danielwilczak101/Evolving-altitude-robot/graphs/Jeff/generation_data.png

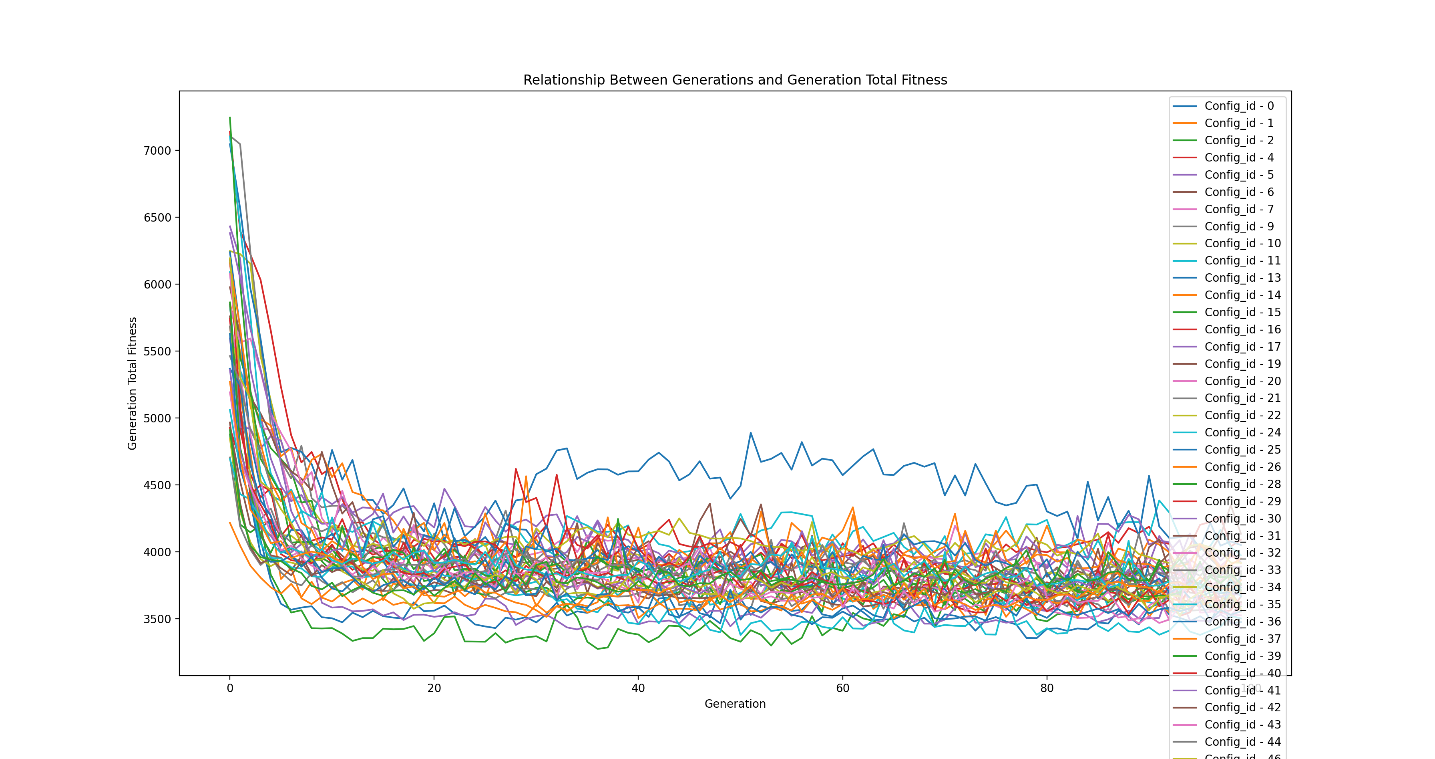
graphs/Jeff/generation_data.png
