danielwilczak101/Evolving-altitude-robot/graphs/Jeff/lowest_chromosome.png

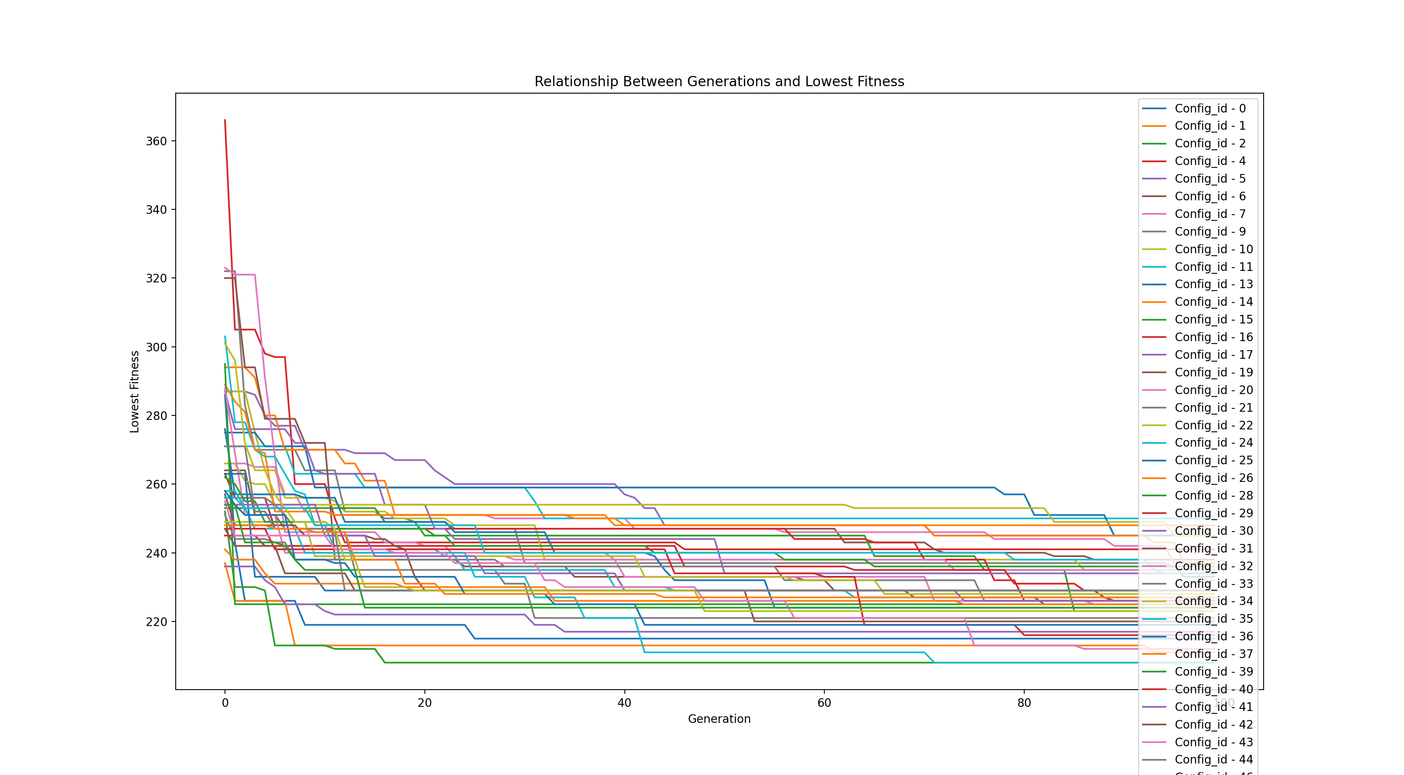
graphs/Jeff/lowest_chromosome.png
