danielwilczak101/Evolving-altitude-robot/graphs/Kyle/Lowest_chromosome.png

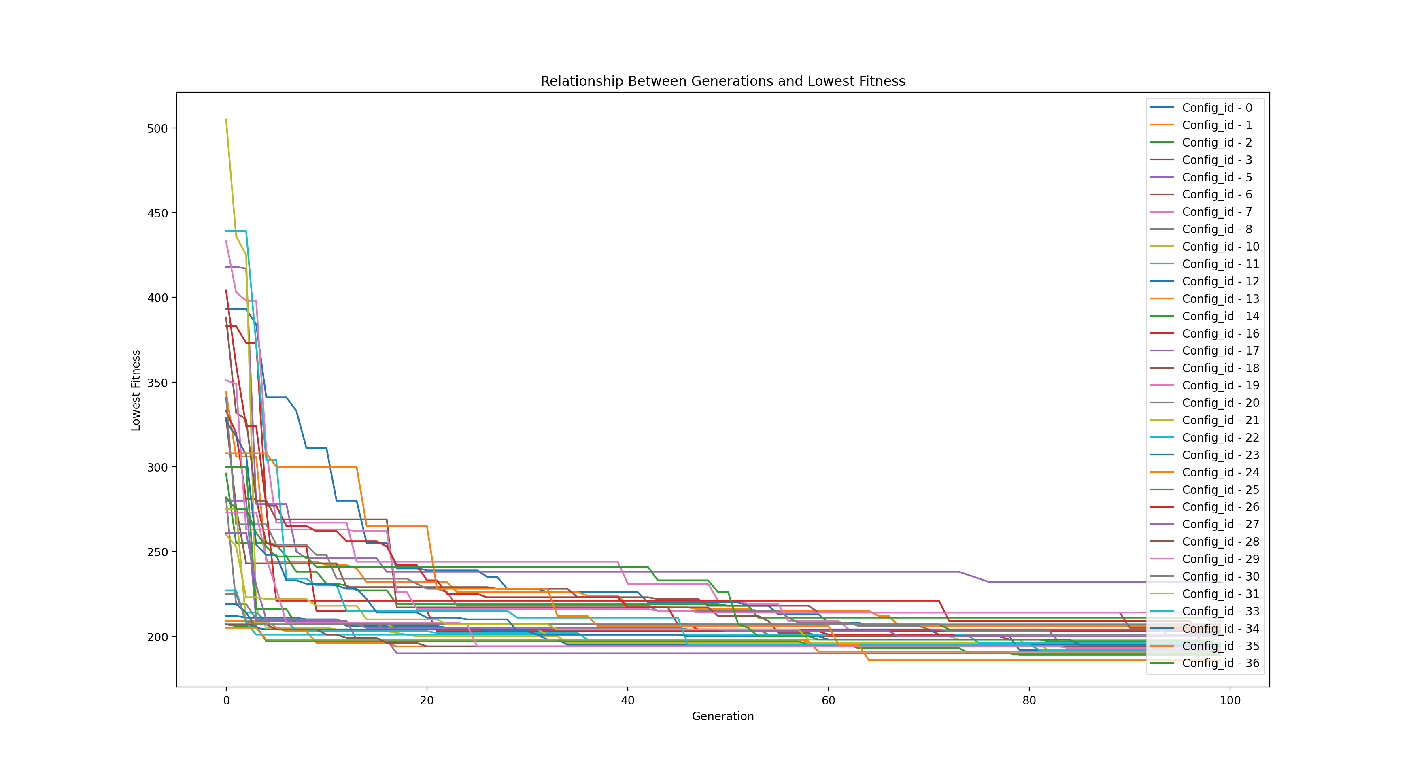
graphs/Kyle/Lowest_chromosome.png
