danielwilczak101/Evolving-altitude-robot/graphs/Linda/Generation_data.png

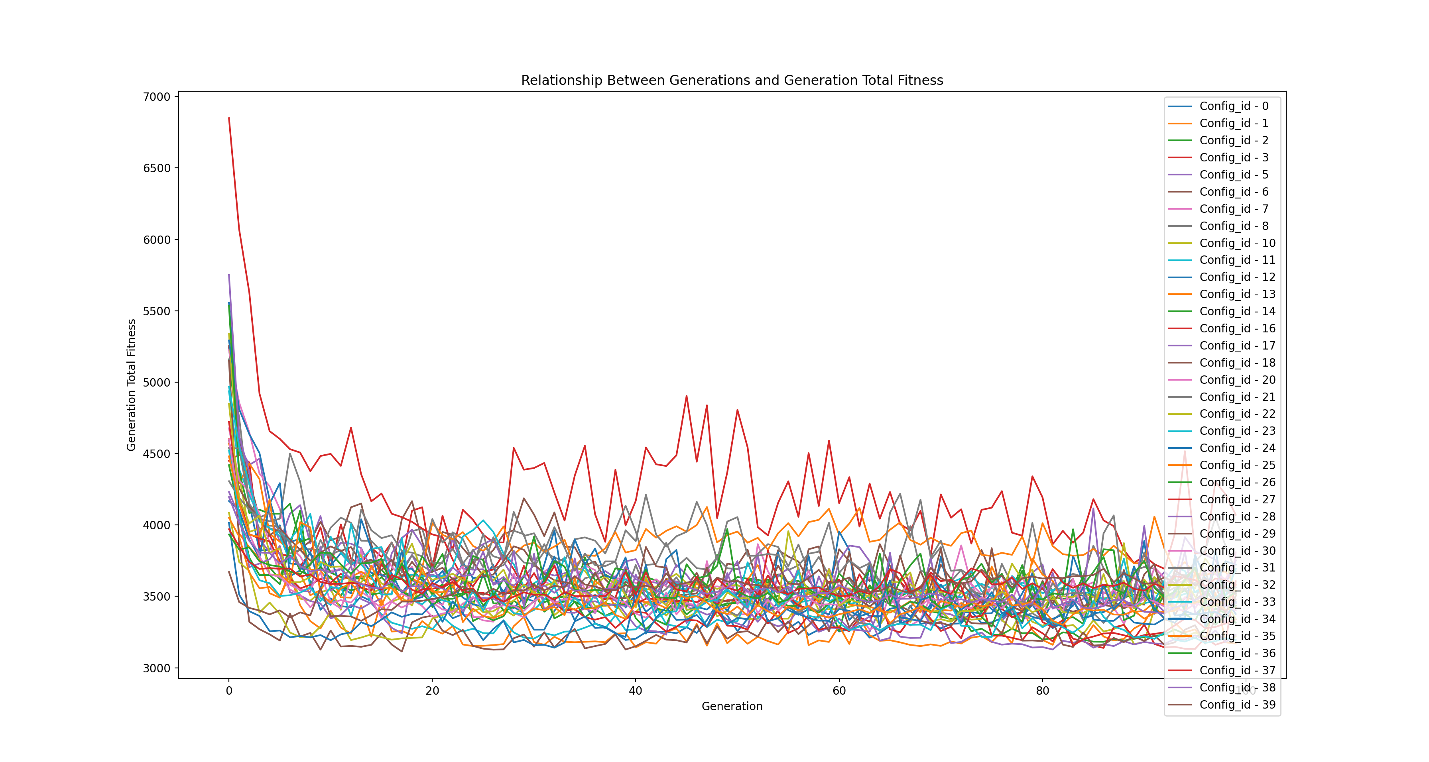
graphs/Linda/Generation_data.png
