danielwilczak101/Evolving-altitude-robot/graphs/Linda/Lowest_chromsome.png

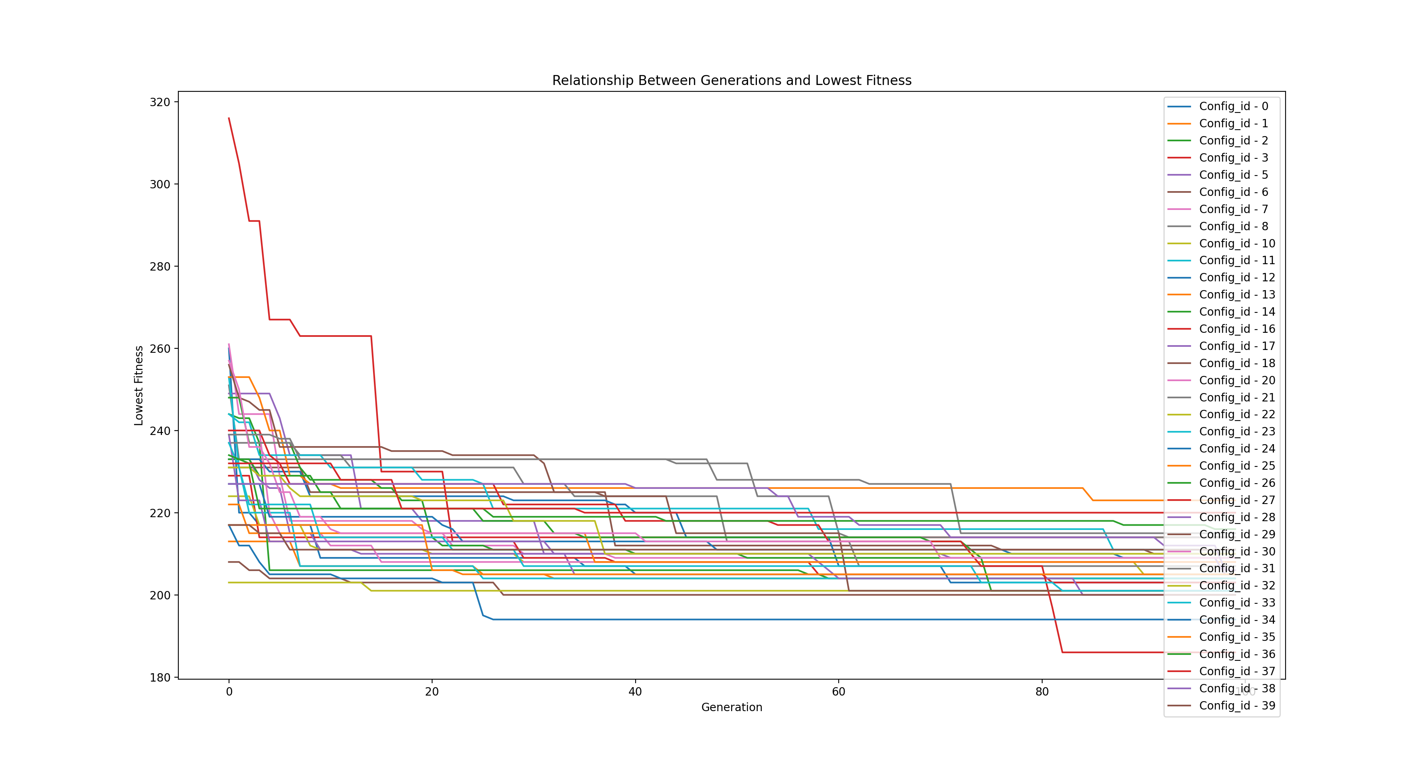
graphs/Linda/Lowest_chromsome.png
