danielwilczak101/Evolving-altitude-robot/3d_print_assembly/Readme.md

## 3D Printing and assembly can be found here.

### STL Files for printing:
All the required 3D printed parts are located in one zipped file on the Thingverse linked below, download, unzip and import into your slicer software to 3D print
<table>
<thead>
<tr>
<th><strong>3D Printed Part</strong></th>
<th align="right"><strong>Quantity</strong></th>
<th><strong>URL</strong></th>
<th><strong>Material</strong></th>
<th><strong>Supports</strong></th>
<th><strong>Print Time</strong></th>
</tr>
</thead>
<tbody>
<tr>
<td>GA Front Test Stand</td>
<td align="right">1</td>
<td><a href="https://www.thingiverse.com/thing:4819932">Thingiverse</a></td>
<td>PLA</td>
<td>Yes: Touching Build Plate Only</td>
<td>10-12 hours</td>
</tr>
<tr>
<td>GA Front Back Stand</td>
<td align="right">1</td>
<td><a href="https://www.thingiverse.com/thing:4819932">Thingiverse</a></td>
<td>PLA</td>
<td>None</td>
<td>10-12 hours</td>
</tr>
<tr>
<td>EDF Holder</td>
<td align="right">1</td>
<td><a href="https://www.thingiverse.com/thing:4819932">Thingiverse</a></td>
<td>PLA</td>
<td>None</td>
<td>6-8 hours</td>
</tr>
<tr>
<td>Hole Guide</td>
<td align="right">1</td>
<td><a href="https://www.thingiverse.com/thing:4819932">Thingiverse</a></td>
<td>PLA</td>
<td>None</td>
<td>4-6 hours</td>
</tr>
</table>

## Assembly

This page details the hardware setup instructions for creating the Evolving Altitude Robot

### Wiring Diagram


### Carbon Fiber Tube and EDF Assembly 
__(add images of 3d prints, carbon fiber tube and how to insert EDF )__

<a href="https://github.com/EREPPLab/Test_WIKI/blob/media/Images/Tube_Alignment_Tool_Uninstalled.JPG">
</a>

<a href="https://github.com/EREPPLab/Test_WIKI/blob/media/Images/Tube_Hole_Alignment_Installed.JPG">
</a>

1. Use the 3D printed Tube Hole Guide to drill a hole in the carbon fiber tube using a 5/32 drill bit
    - Push carbon fiber tube all the way into 3D printed Tube Hole Guide until you hit the wall and then drill hole  

2. Using pliers open up the 3D printed EDF Holder and slide in the EDF to lock in place feeding the wires below
    - Feed wires into the bottom hole on the 3D printed EDF Holder 

3. Feed the 3 wires that you created earlier through the carbon fiber tube
    - Male 3.5 mm bullet connectors opposite of the end of the hole
    - Female 3.5 mm bullet connectors on the same side as the hole you drilled

4. Connect the 3 EDF wires with the 3 connectors of the extension wire

5. Slide the carbon fiber tube into the 3D printed EDF Holder tucking the wires nicely into the cut out

## Hardware Assembly

### Step 1:  Snap in place the Arduino into 3D printed Back Mount
<a href="https://raw.githubusercontent.com/EREPPLab/Test_WIKI/media/Images/Back_Mount_Arduino_Uninstalled.JPG">
</a>

<a href="https://raw.githubusercontent.com/EREPPLab/Test_WIKI/media/Images/Back_Mount_Arduino_part1_insert.JPG">
</a>

<a href="https://raw.githubusercontent.com/EREPPLab/Test_WIKI/media/Images/Back_Mount_Arduino_Installed.JPG">
</a>

<a href="https://raw.githubusercontent.com/EREPPLab/Test_WIKI/media/Images/Back_Mount_Arduino_Installed2.JPG">
</a>

### Step 2:  Snap in place the Ultrasonic sensor into 3D printed Front Mount

<a href="https://raw.githubusercontent.com/EREPPLab/Test_WIKI/media/Images/Front_Mount_Ultrasonic_Outside.JPG">
</a>

<a href="https://raw.githubusercontent.com/EREPPLab/Test_WIKI/media/Images/Front_Mount_Ultrasonic_Inserted.JPG">
</a>

### Step 3:  Slide the Front 3D printed Mount into the Back 3D printed Mount

<a href="https://raw.githubusercontent.com/EREPPLab/Test_WIKI/media/Images/Frount_Back_Mounts_Unassembled.JPG">
</a>

<a href="https://raw.githubusercontent.com/EREPPLab/Test_WIKI/media/Images/Front_Back_Mount_Wire_Connected.JPG">
</a>

### Step 4:  Connect the 4 pin JSD connector wire from the ultrasonic sensor to Arduino shield 4 pin Female JSD connector

### Step 5:  Insert the ESC into the 3D printed Back Mount 
    - 3.5 mm Bullet Connectors and XT60 connector stays sticking out the back
    - Only 3 pin JSD connector feeds through hole to connect to Arduino Shield
<a href="https://raw.githubusercontent.com/EREPPLab/Test_WIKI/media/Images/Back_Mount_ESC_Uninstalled.JPG">
</a>

<a href="https://raw.githubusercontent.com/EREPPLab/Test_WIKI/media/Images/Back_Mount_ESC_Installed.JPG">
</a>

<a href="https://raw.githubusercontent.com/EREPPLab/Test_WIKI/media/Images/Back_Mount_ESC_Installed2.JPG">
</a>

### Step 6: Connect the ESC 3 pin male JSD connector to the Arduino Shield 3 pin female connector  

<a href="https://raw.githubusercontent.com/EREPPLab/Test_WIKI/media/Images/Back_Mount_ESC&Arduino_Installed.JPG">
</a>

<a href="https://raw.githubusercontent.com/EREPPLab/Test_WIKI/media/Images/Back_Mount_ESC_plugedin_Arduino.JPG">
</a>

### Step 7: Line up the Carbon Fiber Drilled Hole with the hole on the Back Mount and insert screw to secure tube in place
    - Make sure to not to tighten bolt too tight allow the carbon fiber tube to easily pivot up and down

### Step 8: Connect the EDF extension wire 3.5 mm male bullet connectors to the ESC 3.5 mm female bullet connectors 
    - If the EDF is spinning the wrong direction swap one of these wires with another

<a href="https://raw.githubusercontent.com/EREPPLab/Test_WIKI/media/Images/Mount_&_Tube_ESC_wires_unconnected.JPG">
</a>

<a href="https://raw.githubusercontent.com/EREPPLab/Test_WIKI/media/Images/Mount_&_ESC_Wires_UnConnected_Zoom.JPG">
</a>

<a href="https://raw.githubusercontent.com/EREPPLab/Test_WIKI/media/Images/Mount_&_ESC_Wires_Connected.JPG">
</a>

<a href="https://raw.githubusercontent.com/EREPPLab/Test_WIKI/media/Images/Mount_&_ESC_Wires_Connected_Zoom.JPG">
</a>

### Congrats your done setting up the Hardware!
